wisrovi/Hospital-smart-bracelet/Web/ServidorPulseraNurcall/build/web/resources/image/iBeacon.jpg

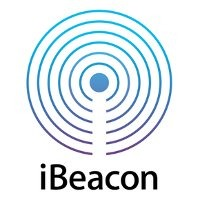
Web/ServidorPulseraNurcall/build/web/resources/image/iBeacon.jpg
