wisrovi/Hospital-smart-bracelet/README.md

# Hospital-smart-bracelet
 Pulsera inteligente hospital
