wisrovi/Hospital-smart-bracelet/Web/ServidorPulseraNurcall/web/resources/image/eddystone.jpg

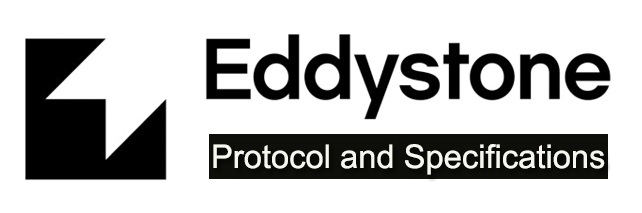
Web/ServidorPulseraNurcall/web/resources/image/eddystone.jpg
