wisrovi/Hospital-smart-bracelet/Componentes Manilla.xls

Sheet: Funcionalidades Manilla
Manilla HSB
Funcionalidad | Componente PCB | Referencia
Deteccion caidas | Acelerometro 3 Ejes | ADXL335 (GY61)
Detectar ubicación | Transmisor beacon | HM10 (CC2540)
Detectar proximidad a valla virtual | Transmisor beacon | HM10 (CC2540)
Detectar si el paciente sigue en su habitación | Transmisor beacon | HM10 (CC2540)
Localizar la persona cuando un sensor supere un umbral establecido | Transmisor beacon | HM10 (CC2540)
Detectar cuando la persona salga de un área (ejemplo: UCI Adultos) | Transmisor beacon | HM10 (CC2540)
Detectar fiebre o hipotermia | Sensor Temperatura | DS18B20
Detectar taquicardia o paro cardiaco | Monitor pulso cardiaco | SEN0203
Detectar cuando la persona se quita la manilla | Sensor Proximidad | QRD1114
Detectar bajo nivel de batería | Sensor nivel batería | ATMEGA328

Sheet: Componentes activos
Cantidad | Componente | Referencia | consumo (mA) | Voltaje Funcionamiento |  | Uso | Taza consulta datos
 |  |  |  | mínimo | máximo |  | actual | máxima
1 | Acelerometro 3 Ejes | ADXL335 (GY61) | -0.35 | 1.8 | 3.6 | Detección choque, movimiento | 20Hz | 550Hz
1 | Monitor pulso cardiaco | SEN0203 | -10 | 3.3 | 6 | Medir pulso cardiaco de la persona | 0,033Hz | 0,033Hz
1 | Sensor Temperatura | DS18B20 | -0.06 |  |  | Medir la temperatura de la persona | 0,016Hz | 0,5Hz
1 | Sensor Proximidad | QRD1114 | -0.3 | 1.8 | 5.6 | Detectar cuando el paciente se quita la pulsera | 0,033Hz | 100Hz
1 | Sensor nivel batería |  | 0 |  |  | Detectar bajo nivel de bateria
1 | Transmisor beacon | HM10 (CC2540) | -9 | 3.3 | 5 | Enviar todos los datos incluyendo la ubicación | 1Hz | 15Hz
1 | Microcontrolador | ATMEGA328 (TQFP-32) | -8 | 1.8 | 5.5 |  | NA | NA
 |  | Consumo carga | -27.71
1 | Bateria litio |  | 850 | 2.7 | 4.1 | Energia para todo el circuito | NA | NA
1 | Carga Inalambrico |  | 80 | NA | NA | Recarga Bateria | NA | NA
1 | Carga Magnetica |  | 2000 | NA | NA | Recarga Bateria | NA | NA
 |  | Horas uso bateria | 31
 | Microcontrolador
 | Pin | Uso | Tipo
 | D0 | Rx | Programador
 | D1 | Tx | Programador
 | D2 | C_bat | Detección sistema cargando
 | D3 | Rx_BLE | UART virtual
 | D4 | Tx_BLE | UART virtual
 | D5 | Vcc DS18B20 | Out digital
 | D6 | Value temperature | Input OneWire
 | D7 | Vcc_ PPM | output digital
 | D8 | Vcc proximidad | output digital
 | D9 | Value proximidad | input digital
 | D10 | vcc acelerometro | output digital
 | D11 | MOSI – programación | digital
 | D12 | MISO – programación | digital
 | D13 | SCK – programación | digital
 | A0 | Value PPM | analog input
 | A1 | Vcc BLE | output digital
 | A2 | acelerometro X | analog input
 | A3 | acelerometro Y | analog input
 | A4 | acelerometro Z | analog input
 | A5 | sensar nivel bateria | analog input
 | A6
 | A7

Sheet: Componentes Pasivos
Componente
Módulo Bluetooth 4.0 HM-10 CC2540/CC2541 BLE Rs232
Micro ATMEGA328P TQFP-32
Resistencia 4.7KΩ 1206 SMD 1/4W
Resistencia 10KΩ 1206 SMD 1/4W
Resistencia 1KΩ 1206 SMD 1/4W
Pulsador pequeño SMD 4 pines - 1mm
Resistencia 330KΩ 1206 SMD 1/4W
Cristal 16 MHz superficial Ref: CRT-16MHZ-SMD
Condensador 22pF 50V encapsulado 0805
Resistencia 2KΩ 1206 SMD 1/4W
Resistencia 680KΩ 1206 SMD 1/4W
Capacitor cerámico 0.1uF 50V encapsulado 0805
Batería Litio-Polímero 3.7V 850mAh
Cargador micro-USB para batería litio - 3.7v
Modulo de carga inalambrica - 5V / 600mA
Conector Macho JST PH 2 Posiciones (recto)
Cable JST PH 2 lineas
Capacitor electrolítico aluminio 680uF 16V SMD
