wisrovi/Hospital-smart-bracelet/Componentes HSB y Baliza/Listado de componentes Baliza y HSB.xlsx

Sheet: Componentes HSB
Componentes HSB
Producto | Imagén | URL Página | Proveedor | Cantidad Actual | Cantidad Requerida | Precio Unidad | Precio Total | Precio Unidad Costo por Manilla
PCB |  |  |  | 5 | 0 | $0.00 | $0.00 | $24000.00
Módulo Bluetooth 4.0 HM-10 CC2540/CC2541 BLE Rs232 | Imagen | Link (https://www.ardobot.co/modulo-bluetooth-4-0-hm-10-cc2540-cc2541-ble-rs232.html) | Ardobot | 2 | 2 | $27500.00 | $55000.00 | $27500.00
Micro ATMEGA328P TQFP-32 | Imagen | Link (https://www.didacticaselectronicas.com/index.php/microcontroladores/atmel/microcontrolador-atmel-atmega328p-mcu-tqfp-32-detail) | Didacticaselectronicas | 3 | 2 | $12257.00 | $24514.00 | $12257.00
Monitor de ritmo cardíaco PPM SEN0203 | Imagen | Link (https://www.didacticaselectronicas.com/index.php/sensores/biomedicos/monitor-ritmo-cardiaco-sensor-sensores-de-medidor-pulso-card%C3%ADaco-ritmo-card%C3%ADaco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) | Didacticaselectronicas | 1 | 3 | $83300.00 | $249900.00 | $83300.00
Sensor Digital de Temperatura DS18B20 | Imagen | Link (https://www.didacticaselectronicas.com/index.php/sensores/temperatura/termometro-digital-de-resolucion-programable-to-92-sensor-sensores-de-temperatura-termom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) | Didacticaselectronicas | 3 | 2 | $4403.00 | $8806.00 | $4403.00
Resistencia 4.7KΩ 1206 SMD 1/4W | Imagen | Link (https://www.didacticaselectronicas.com/index.php/componentes-pasivos/resistencias/montaje-superficial-smd/1206-1/resistencias-1206-smd-4-7k-1-4w-superficial-1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) | Didacticaselectronicas | 0 | 10 | $49.98 | $499.80 | $49.98
Sensor Acelerómetro de 3 Ejes ADXL335 GY61 | Imagen | Link (https://www.didacticaselectronicas.com/index.php/sensores/acelerometros-gyros/modulo-acelerometro-adxl335-tarjetas-sensores-aceler%C3%B3metros-3-ejes-3-grados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) | Vistronica | 3 | 3 | $13299.44 | $39898.32 | $13299.44
Sensor Proximidad QRD1114 | Imagen | https://www.didacticaselectronicas.com/index.php/robotica/seguidores-de-linea-1/sensor-optico-reflectivo-sensor-seguidor-de-linea-seguidores-de-lineas-seguimi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 | Didacticaselectronicas | 1 | 4 | $1785.00 | $7140.00 | $1785.00
Resistencia 10KΩ 1206 SMD 1/4W | Imagen |  |  |  | 0 | $0.00 | $0.00 | $49.98
Resistencia 1KΩ 1206 SMD 1/4W | Imagen |  |  |  | 0 | $0.00 | $0.00 | $49.98
Pulsador pequeño SMD 4 pines - 1mm | Imagen | Link (https://www.didacticaselectronicas.com/index.php/suiches-y-conectores/suiches/pulsadores/pulsador-peque%C3%B1o-smd-4-pines-1mm-interruptor-switch-suiche-pulsa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) | Didacticaselectronicas | 11 | 10 | $330.20 | $3302.00 | $330.20
Resistencia 330KΩ 1206 SMD 1/4W | Imagen | Link (https://www.didacticaselectronicas.com/index.php/componentes-pasivos/resistencias/montaje-superficial-smd/1206-1/resistencias-1206-330-ohm-smd-14w-resistencia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) | Didacticaselectronicas |  | 10 | $49.98 | $499.80 | $49.98
Cristal 16 MHz superficial Ref: CRT-16MHZ-SMD | Imagen | Link (https://www.didacticaselectronicas.com/index.php/componentes-pasivos/cristales-y-osciladores/cristal-16-mhz-superficial2016-02-08-04-34-49_-smd-oscilador-reso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) | Didacticaselectronicas | 4 | 10 | $404.60 | $4046.00 | $404.60
Condensador 22pF 50V encapsulado 0805 | Imagen | Link (https://www.didacticaselectronicas.com/index.php/componentes-pasivos/capacitores/ceramicos/capacitor-ceramico-22pf-50v-encapsulado-0805-caondensadores-capacit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) | Didacticaselectronicas | 10 | 10 | $70.21 | $702.10 | $70.21
Resistencia 2KΩ 1206 SMD 1/4W | Imagen |  |  |  | 0 | $0.00 | $0.00 | $49.98
Resistencia 680KΩ 1206 SMD 1/4W | Imagen |  |  |  | 0 | $0.00 | $0.00 | $49.98
Capacitor cerámico 0.1uF 50V encapsulado 0805 | Imagen | Link (https://www.didacticaselectronicas.com/~didactic/index.php/componentes-pasivos/capacitores/ceramicos/capacitor-ceramico-01uf-50v-encapsulado-0805-condensadore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) | Didacticaselectronicas | 1 | 10 | $40.46 | $404.60 | $40.46
Batería Litio-Polímero 3.7V 850mAh | Imagen | Link (https://www.didacticaselectronicas.com/index.php/baterias-cargadores/recargables-1/tipo-lipo-1/3-7v/bater%C3%ADa-litio-pol%C3%ADmero-3-7v-850mah-ion-pol-35709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) | Didacticaselectronicas | 2 | 2 | $17850.00 | $35700.00 | $17850.00
Cargador micro-USB para batería litio - 3.7v | Imagen | Link (https://www.didacticaselectronicas.com/index.php/baterias-cargadores/cargadores-1/tp4056-3-cargador-micro-usb-para-bater%C3%ADa-litio-3-7v-1s-cargador-control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) | Didacticaselectronicas | 1 | 3 | $3808.00 | $11424.00 | $3808.00
Modulo de carga inalambrica - 5V / 600mA | Imagen | Link (https://www.ardobot.co/modulo-de-carga-inalambrica-5v-600ma.html) | Ardobot | 1 | 1 | $38250.00 | $38250.00 | $38250.00
Conector Macho JST PH 2 Posiciones (recto) | Imagen | Link (https://www.didacticaselectronicas.com/index.php/suiches-y-conectores/conectores2016-02-07-20-36-39_/jst-1/conector-macho-ph-2-posiciones-recto-conector-ph-js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) | Didacticaselectronicas | 1 | 5 | $737.80 | $3689.00 | $737.80
Cable JST PH 2 lineas | Imagen | Link (https://www.didacticaselectronicas.com/index.php/cables/con-conector/jst/cable-doble-con-conector-hembra-jst-ph-2p-a%C3%A9reo-dos-lineas-pololu-cable-doble-js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) | Didacticaselectronicas | 1 | 5 | $1190.00 | $5950.00 | $1190.00
Capacitor electrolítico aluminio 680uF 16V SMD | Imagen | https://www.didacticaselectronicas.com/index.php/componentes-pasivos/capacitores/electrolitico-aluminio/montaje-superficial-smd-1/capacitor-electrol%C3%ADtico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 | Didacticaselectronicas | 1 | 4 | $749.70 | $2998.80 | $749.70
 |  |  |  |  |  | TOTAL | $492724.42 | $230275.29
Proveedor |  | Total | Envío | Total
Vistronica |  | $39898.32 | $11500.00 | $51398.32
Ardobot |  | $93250.00 | $13000.00 | $106250.00
Didacticaselectronicas |  | $359576.10 | $11900.00 | $371476.10
Total |  | $492724.42 |  | $529124.42

Sheet: Componentes Baliza
Componentes Baliza
Producto | URL Página | Proveedor | Cantidad Actual | Cantidad Requerida | Precio Unidad | Precio Total
PCB | - | - | 1 | 0 | $0 | $0
ESP32s | Link (https://www.ardobot.co/board-de-desarrollo-con-modulo-esp32-wifi-bluetooth-ble.html) | Ardobot | 4 | 1 | $30200.00 | $30200.00
HM10 | Link (https://www.ardobot.co/modulo-bluetooth-4-0-hm-10-cc2540-cc2541-ble-rs232.html) | Ardobot | 4 | 1 | $27500.00 | $27500.00
 |  |  |  |  | TOTAL | $57700.00

Sheet: Fotos componentes
Componente | Imagen
Módulo Bluetooth 4.0 HM-10 CC2540/CC2541 BLE Rs232
Micro ATMEGA328P TQFP-32
Monitor de ritmo cardíaco PPM SEN0203
Sensor Digital de Temperatura DS18B20
Resistencia 4.7KΩ 1206 SMD 1/4W
Sensor Acelerómetro de 3 Ejes ADXL335 GY61
Sensor Proximidad QRD1114
Resistencia 10KΩ 1206 SMD 1/4W
Resistencia 1KΩ 1206 SMD 1/4W
Pulsador pequeño SMD 4 pines - 1mm
Resistencia 330KΩ 1206 SMD 1/4W
Cristal 16 MHz superficial Ref: CRT-16MHZ-SMD
Condensador 22pF 50V encapsulado 0805
Resistencia 2KΩ 1206 SMD 1/4W
Resistencia 680KΩ 1206 SMD 1/4W
Capacitor cerámico 0.1uF 50V encapsulado 0805
Batería Litio-Polímero 3.7V 850mAh
Cargador micro-USB para batería litio - 3.7v
Modulo de carga inalambrica - 5V / 600mA
Conector Macho JST PH 2 Posiciones (recto)
Cable JST PH 2 lineas
Capacitor electrolítico aluminio 680uF 16V SMD
