wisrovi/Hospital-smart-bracelet/Componentes HSB y Baliza/Listado de componentes para proveedor.xlsx

Sheet: Componentes HSB
Producto | Imagén | Cantidad Requerida 4 HSB 5 Balizas | Cantidad Requerida 3 HSB 4 Balizas | Cantidad Requerida 2 HSB 4 Balizas | Cantidad Actual
Módulo Bluetooth 4.0 HM-10 CC2540/CC2541 BLE Rs232 | Imagen | 3 | 1 | 1 | 6
Micro ATMEGA328P TQFP-32 | Imagen | 4 | 3 | 2 | 2
Monitor de ritmo cardíaco PPM SEN0203 | Imagen | 3 | 2 | 1 | 1
Sensor Digital de Temperatura DS18B20 | Imagen | 4 | 3 | 2 | 2
Resistencia 4.7KΩ 1206 SMD 1/4W | Imagen | 10 | 10 | 10 | 0
Sensor Acelerómetro de 3 Ejes ADXL335 GY61 | Imagen | 2 | 1 | 1 | 3
Sensor Proximidad QRD1114 | Imagen | 5 | 4 | 3 | 1
Resistencia 10KΩ 1206 SMD 1/4W | Imagen | 10 | 10 | 10 | 0
Resistencia 1KΩ 1206 SMD 1/4W | Imagen | 10 | 10 | 10 | 0
Pulsador pequeño SMD 4 pines - 1mm | Imagen | 10 | 10 | 10 | 0
Resistencia 330 Ω 1206 SMD 1/4W | Imagen | 10 | 10 | 10 | 0
Cristal 16 MHz superficial Ref: CRT-16MHZ-SMD | Imagen | 10 | 10 | 10 | 0
Condensador 22pF 50V encapsulado 0805 | Imagen | 10 | 10 | 10 | 0
Resistencia 2KΩ 1206 SMD 1/4W | Imagen | 10 | 10 | 10 | 0
Resistencia 680 Ω 1206 SMD 1/4W | Imagen | 10 | 10 | 10 | 0
Capacitor cerámico 0.1uF 50V encapsulado 0805 | Imagen | 10 | 10 | 10 | 0
Batería Litio-Polímero 3.7V 850mAh | Imagen | 3 | 2 | 1 | 2
Cargador micro-USB para batería litio - 3.7v | Imagen | 3 | 2 | 1 | 1
Modulo de carga inalambrica - 5V / 600mA | Imagen | 1 | 1 | 1 | 1
Conector Macho JST PH 2 Posiciones (recto) | Imagen | 5 | 5 | 5 | 1
Cable JST PH 2 lineas | Imagen | 5 | 5 | 5 | 1
Capacitor electrolítico aluminio 680uF 16V SMD | Imagen | 10 | 10 | 10 | 0
Módulo ESP32 WiFi+Bluetooth BLE | Imagen | 2 | 1 | 0 | 3
Resistencia 100 Ω 1206 SMD 1/4W | Imagen | 10 | 10 | 10 | 0

Sheet: Vistronica
ITEM | NOMBRE DEL PRODUCTO | Referencia | UNIDAD DE MEDIDA | CANTIDAD | VALOR UNITARIO | VALOR TOTAL SIN IVA | VALOR IVA | VALOR TOTAL CON IVA
1 | MÓDULO BLUETOOTH 4.0BLE AT- 09 CC2541 HM-10 | VIS2412 | Unidad | 3 | $14500 | $43500.00 | $8265.00 | $51765.00
2 | MICROCONTROLADOR ATMEGA328P SMD TQFP-32 | VIS2842 | Unidad | 2 | $8248 | $16495.80 | $3134.20 | $19630.00
3 | Gravity: Heart Rate Monitor Sensor for Arduino SEN0203 |  | Unidad | 3 | $78125 | $234375.13 | $44531.27 | $278906.40
4 | SENSOR DIGITAL DE TEMPERATURA DS18B20 | VIS304 | Unidad | 2 | $3697 | $7394.96 | $1405.04 | $8800.00
5 | RESISTENCIAS 4.7 KOHM SMD 1206 1/4W 5% X10 | VIS2935 | Unidad | 10 | $286 | $2857.14 | $542.86 | $3400.00
6 | ACELERÓMETRO DE 3 EJES ADXL335 GY61 | VIS1435 | Unidad | 3 | $11176 | $33526.89 | $6370.11 | $39897.00
7 | SENSOR ÓPTICO REFLEXIVO QRD1114 | VIS1262 | Unidad | 4 | $2400 | $9600.00 | $1824.00 | $11424.00
8 | Resistencia 10KΩ 1206 SMD 1/4W |  | Unidad | 10 | $78 | $780.00 | $148.20 | $928.20
9 | Resistencia 1KΩ 1206 SMD 1/4W |  | Unidad | 20 | $78 | $1560.00 | $296.40 | $1856.40
10 | MICRO PULSADOR DE 4 PINES 6*6*7 SMD | VIS2344 | Unidad | 10 | $80 | $800.00 | $152.00 | $952.00
11 | Resistencia 330KΩ 1206 SMD 1/4W |  | Unidad | 10 | $80 | $800.00 | $152.00 | $952.00
12 | CRISTAL OSCILADOR DE 16 MHZ SMD HC-49S | VIS2838 | Unidad | 10 | $306 | $3060.00 | $581.40 | $3641.40
13 | CAPACITOR CERÁMICO 22 PF 50V YAGEO SMD 0805 X10 | VIS3030 | Unidad | 10 | $403 | $4033.61 | $766.39 | $4800.00
14 | Resistencia 2KΩ 1206 SMD 1/4W |  | Unidad | 10 | $80 | $800.00 | $152.00 | $952.00
15 | Resistencia 680KΩ 1206 SMD 1/4W |  | Unidad | 10 | $80 | $800.00 | $152.00 | $952.00
16 | Capacitor cerámico 0.1uF 50V encapsulado 0805 |  | Unidad | 10 | $247 | $2470.00 | $469.30 | $2939.30
17 | BATERÍA DE LIPO 3.7V 1240 MAH | VIS1839 | Unidad | 2 | $18992 | $37983.19 | $7216.81 | $45200.00
18 | MODULO CARGADOR DE BATERÍAS LIPO MICRO USB 5V 1A TP4056 paa baterias de 3,7v | VIS2680 | Unidad | 3 | $2200 | $6600.00 | $1254.00 | $7854.00
19 | MODULO FUENTE DE ALIMENTACIÓN INALÁMBRICA XKT-412 5V 1 A | VIS1692 | Unidad | 1 | $48700 | $48700.00 | $9253.00 | $57953.00
20 | Conector Macho JST PH 2 Posiciones (recto) |  | Unidad | 5 | $959 | $4795.71 | $911.19 | $5706.90
21 | Cable JST PH 2 lineas |  | Unidad | 5 | $1547 | $7735.00 | $1469.65 | $9204.65
22 | Capacitor electrolítico aluminio 680uF 16V SMD |  | Unidad | 4 | $975 | $3898.45 | $740.71 | $4639.16
23 | BOARD NODEMCU WIFI BASADO EN ESP32 | VIS2674 | Unidad | 1 | $27720 | $27720.00 | $5266.80 | $32986.80
 |  |  |  |  |  | SUBTOTAL | $500286
 |  |  |  |  |  | IVA | $95054
 |  |  |  |  |  | ENVÍO | $12000
 |  |  |  |  |  | VALOR TOTAL | $607340

Sheet: Ardobot
Producto | Precio Unidad | Cantidad Requerida 4 HSB 5 Balizas | Precio Total | Cantidad Requerida 3 HSB 4 Balizas | Precio Total | Cantidad Requerida 2 HSB 3 Balizas | Precio Total | Cantidad Requerida 2 HSB 3 Balizas | Precio Total
Módulo Bluetooth 4.0 HM-10 CC2540/CC2541 BLE Rs232 | $27500 | 3 | $82500 | 1 | $27500 | 0 | $0 | 0 | $0
Micro ATMEGA328P TQFP-32 | $15200 | 4 | $60800 | 3 | $45600 | 2 | $30400 | 2 | $30400
Monitor de ritmo cardíaco PPM SEN0203 | $87000 | 3 | $261000 | 2 | $174000 | 1 | $87000 | 2 | $174000
Sensor Digital de Temperatura DS18B20 | $6999 | 4 | $27996 | 3 | $20997 | 2 | $13998 | 1 | $6999
Resistencia 4.7KΩ 1206 SMD 1/4W | $50 | 10 | $500 | 10 | $500 | 10 | $500 | 10 | $500
Sensor Acelerómetro de 3 Ejes ADXL335 GY61 | $14900 | 2 | $29800 | 1 | $14900 | 1 | $14900 | 0 | $0
Sensor Proximidad QRD1114 | $3500 | 4 | $14000 | 4 | $14000 | 3 | $10500 | 2 | $7000
Resistencia 10KΩ 1206 SMD 1/4W | $60 | 10 | $600 | 10 | $600 | 10 | $600 | 10 | $600
Resistencia 1KΩ 1206 SMD 1/4W | $50 | 10 | $500 | 10 | $500 | 10 | $500 | 10 | $500
Pulsador pequeño SMD 4 pines - 1mm | $550 | 10 | $5500 | 10 | $5500 | 10 | $5500 | 10 | $5500
Resistencia 330 Ω 1206 SMD 1/4W | $50 | 10 | $500 | 10 | $500 | 10 | $500 | 10 | $500
Cristal 16 MHz superficial Ref: CRT-16MHZ-SMD | $500 | 10 | $5000 | 10 | $5000 | 10 | $5000 | 10 | $5000
Condensador 22pF 50V encapsulado 0805 | $250 | 10 | $2500 | 10 | $2500 | 10 | $2500 | 10 | $2500
Resistencia 2KΩ 1206 SMD 1/4W | $50 | 10 | $500 | 10 | $500 | 10 | $500 | 10 | $500
Resistencia 680 Ω 1206 SMD 1/4W | $50 | 10 | $500 | 10 | $500 | 10 | $500 | 10 | $500
Capacitor cerámico 0.1uF 50V encapsulado 0805 | $580 | 10 | $5800 | 10 | $5800 | 10 | $5800 | 10 | $5800
Batería Litio-Polímero 3.7V 850mAh | $28500 | 3 | $85500 | 2 | $57000 | 1 | $28500 | 1 | $28500
Cargador micro-USB para batería litio - 3.7v | $15000 | 3 | $45000 | 2 | $30000 | 1 | $15000 | 1 | $15000
Modulo de carga inalambrica - 5V / 600mA | $38250 | 1 | $38250 | 1 | $38250 | 1 | $38250 | 1 | $38250
Conector Macho JST PH 2 Posiciones (recto) | $1550 | 5 | $7750 | 5 | $7750 | 5 | $7750 | 5 | $7750
Cable JST PH 2 lineas | $1800 | 5 | $9000 | 5 | $9000 | 5 | $9000 | 5 | $9000
Capacitor electrolítico aluminio 680uF 16V SMD | $850 | 10 | $8500 | 10 | $8500 | 10 | $8500 | 10 | $8500
Módulo ESP32 WiFi+Bluetooth BLE | $35680 | 2 | $71360 | 1 | $35680 | 0 | $0 | 0 | $0
Resistencia 100 Ω 1206 SMD 1/4W | $50 | 10 | $500 | 10 | $500 | 10 | $500 | 10 | $500
 |  | TOTAL | $763856 | TOTAL | $505577 | TOTAL | $286198 | TOTAL | $347799
Corregir las resistencias son de 680Ω y 330Ω

Sheet: Fotos componentes
Componente | Imagen
Módulo Bluetooth 4.0 HM-10 CC2540/CC2541 BLE Rs232
Micro ATMEGA328P TQFP-32
Monitor de ritmo cardíaco PPM SEN0203
Sensor Digital de Temperatura DS18B20
Resistencia 4.7KΩ 1206 SMD 1/4W
Sensor Acelerómetro de 3 Ejes ADXL335 GY61
Sensor Proximidad QRD1114
Resistencia 10KΩ 1206 SMD 1/4W
Resistencia 1KΩ 1206 SMD 1/4W
Pulsador pequeño SMD 4 pines - 1mm
Resistencia 330KΩ 1206 SMD 1/4W
Cristal 16 MHz superficial Ref: CRT-16MHZ-SMD
Condensador 22pF 50V encapsulado 0805
Resistencia 2KΩ 1206 SMD 1/4W
Resistencia 680KΩ 1206 SMD 1/4W
Capacitor cerámico 0.1uF 50V encapsulado 0805
Batería Litio-Polímero 3.7V 850mAh
Cargador micro-USB para batería litio - 3.7v
Modulo de carga inalambrica - 5V / 600mA
Conector Macho JST PH 2 Posiciones (recto)
Cable JST PH 2 lineas
Capacitor electrolítico aluminio 680uF 16V SMD
Módulo ESP32 WiFi+Bluetooth BLE
Resistencia 100 Ω 1206 SMD 1/4W
