wisrovi/Hospital-smart-bracelet/Pulsera/Componentes HSB.xlsx

Sheet: Productos
Producto | Precio | Unidades | Total | URL
Acelerómetro de 3 Ejes ADXL335 GY61 | $13299 | 2 | $26598 | https://www.vistronica.com/sensores/imu/acelerometro-de-3-ejes-adxl335-gy61-detail.html
Sensor Digital de Temperatura DS18B20 | $4400 | 3 | $13200 | https://www.vistronica.com/sensores/temperatura/sensor-digital-de-temperatura-ds18b20-detail.html
Resistencias 100 KOHM SMD 1206 1/4W 5% x10 | $340 | 1 | $340 | https://www.vistronica.com/componentes-pasivos/resistencias/resistencias-100-kohm-smd-1206-14w-5-x10-detail.html
Resistencias 1 MOHM SMD 1206 1/4W 5% x10 | $340 | 1 | $340 | https://www.vistronica.com/componentes-pasivos/resistencias/resistencias-1-mohm-smd-1206-14w-5-x10-detail.html
Resistencias 22 KOHM SMD 1206 1/4W 5% x10 | $340 | 1 | $340 | https://www.vistronica.com/componentes-pasivos/resistencias/resistencias-22-kohm-smd-1206-14w-5-x10-detail.html
Resistencias 47 KOHM SMD 1206 1/4W 5% x10 | $340 | 1 | $340 | https://www.vistronica.com/componentes-pasivos/resistencias/resistencias-47-kohm-smd-1206-14w-5-x10-detail.html
Resistencias 470 KOHM SMD 1206 1/4W 5% x10 | $340 | 1 | $340 | https://www.vistronica.com/componentes-pasivos/resistencias/resistencias-470-kohm-smd-1206-14w-5-x10-detail.html
Total |  |  | $41498
Envío |  |  | $11000
Total con Envío |  |  | $52498

Sheet: Calculos Vout
Resistencias
Resistencias 1 MOHM SMD 1206 1/4W 5% x10
Resistencias 680 KOHM SMD 1206 1/4W 5% x10
Resistencias 470 KOHM SMD 1206 1/4W 5% x10
Resistencias 100 KOHM SMD 1206 1/4W 5% x10
Resistencias 47 KOHM SMD 1206 1/4W 5% x10
Resistencias 22 KOHM SMD 1206 1/4W 5% x10
Resistencias 680 OHM SMD 1206 1/4W 5% x10
Resistencias 100 OHM SMD 1206 1/4W 5% x10
Resistencias 82 OHM SMD 1206 1/4W 5% x10
Resistencias 68 OHM SMD 1206 1/4W 5% x10
 | R1 | R2 | Vout
 | 100KOhm | 47KOhm | 1.342857143
 | 1MOhm | 470KOhm | 1.342857143
 | 47KOhm | 22KOhm | 1.339130435
 | 1MOhm | 105
 | 470KOhm | 474
 | 22KOhm | 223
 | 47KOhm | 473
 | 100KOhm
 | 100Ohm | 101
