wisrovi/Hospital-smart-bracelet/Pulsera/PCB/Proveedor/FORMATO INFORMACION COMPONENTES PARA COTIZAR (BOM) (Enero 30 2019).xlsx

Sheet: PORTADA
 | ADVERTENCIA: DOCUMENTO ALTAMENTE
 | CONFIDENCIAL PROTEGIDO BAJO SECRETO
 | INDUSTRIAL ART.262 DECISIÓN 486 DE 2000
ESTE DOCUMENTO CONTIENE SECRETOS INDUSTRIALES DE COLCIRCUITOS S.A.S Y SOLO PUEDE SER CONSULTADO O REVELADO POR PERSONAS AUTORIZADAS POR EL TITULAR. LA VISUALIZACIÓN O LA DIVULGACIÓN NO AUTORIZADAS ESTÁN ESTRICTAMENTE PROHIBIDAS Y PUEDEN GENERAR GRAVES SANCIONES LEGALES
 | TITULAR DEL DOCUMENTO LILIANA VELEZ PEREZ (Representante ante el SGC) C.C. 43.749.879
Cotizar pero NO ensamblar
No ensamblar y no cotizar
Cliente lo suministra
Capa Top
Capa Botton
Ambas Capas

Sheet: Listado de COMPONENTES (BOM)
 |  | FORMATO CON LA INFORMACIÓN DE COMPONENTES (BOM) |  |  |  | Código: COM - F
 |  |  |  |  |  | Versión: 04
 |  |  |  |  |  | Fecha: 29 - 01 - 2019
INDICACIONES DE USO DEL FORMATO: Para realizar una correcta manufactura electrónica, es necesario el diligenciamiento de este formato con la información de los componentes de los que está compuesto su proyecto. Agradecemos entregarnos la información específica, sobre todo de la referencia del fabricante del componente y apoyarse en los comentarios de los títulos de la tabla para una mayor información.
ITEM | N° DE PARTE - Según máscara de componentes en la PCB | CANTIDAD DEL COMPONENTE EN LA PCB | DESCRIPCIÓN DEL COMPONENTE | REFERENCIA DE FABRICANTE | UBICACIÓN DEL COMPONENTE - Top o Botton | OBSERVACIONES - indicar si aplica, una de las opciones

Sheet: ORDEN DE ITEM EN EL BOM
SUGERENCIA DE ORDEN DE ITEM PARA EL LISTADO DE COMPONENTES
Resistencias
Condensadores
Diodos
Leds
Bobinas
Fusibles
Cristales
Buzzer
Transistores
Mosfet
Triacs, Diacs, Varistores
Reguladores
Optocopladores
Micros
Modulos GPS GPRS
Displays
Cables
Bases integrados
Baterias
Relevos
Switches
Conectores
Borneras
Conectores ribbon
Cajas
Tornillos
Antenas
