wisrovi/Hospital-smart-bracelet/Pulsera/PCB/Hospital-Smart-Bracelet V1.1/Project Outputs for Hospital-Smart-Bracelet/ExportSTEP/HSB-Version1.step

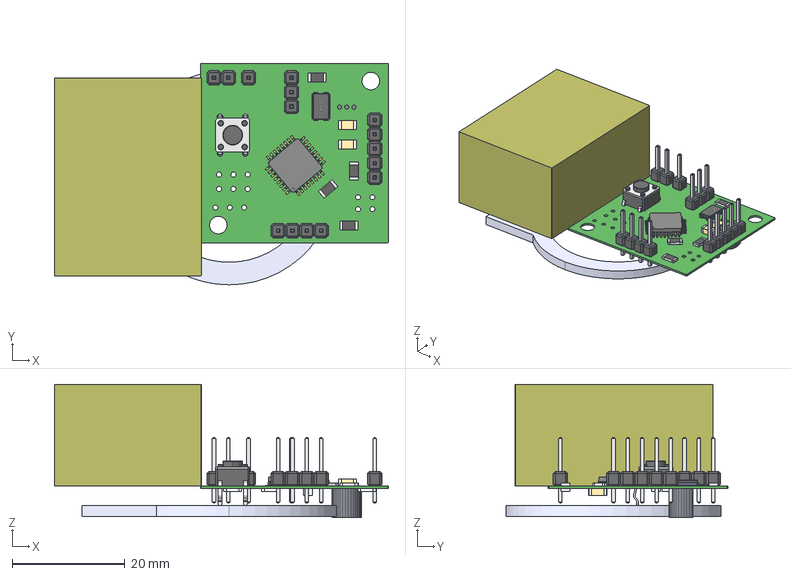
[picture p23: CAD file, 2020-05-28]
Pulsera/PCB/Hospital-Smart-Bracelet V1.1/Project Outputs for Hospital-Smart-Bracelet/ExportSTEP/HSB-Version1.step
59.1 x 39.2 x 23.6 mm
Board
1x1x2.54_Pin_Header_TH_V x 15
C1206-1.25 x 6
R1206-0.55 x 14
2-SMD
Tack_Switch_6x6_1mm
User_Library-QFP32_User_Library-PQFP_32_P0.8_QFPbody_1
User_Library-QFP32_User_Library-PQFP_32_P0.8_QFPleg_1 x 16
User_Library-QFP32_User_Library-PQFP_32_P0.8_QFPleg_MIR1_1 x 8
User_Library-QFP32_User_Library-PQFP_32_P0.8_QFPleg_MIR_1 x 8
Extruded x 2
Base_anillo1
