wisrovi/Hospital-smart-bracelet/Pulsera/PCB/Hospital-Smart-Bracelet V1.1/Project Outputs for Hospital-Smart-Bracelet/gerberEnviar/HSB-Version1.step

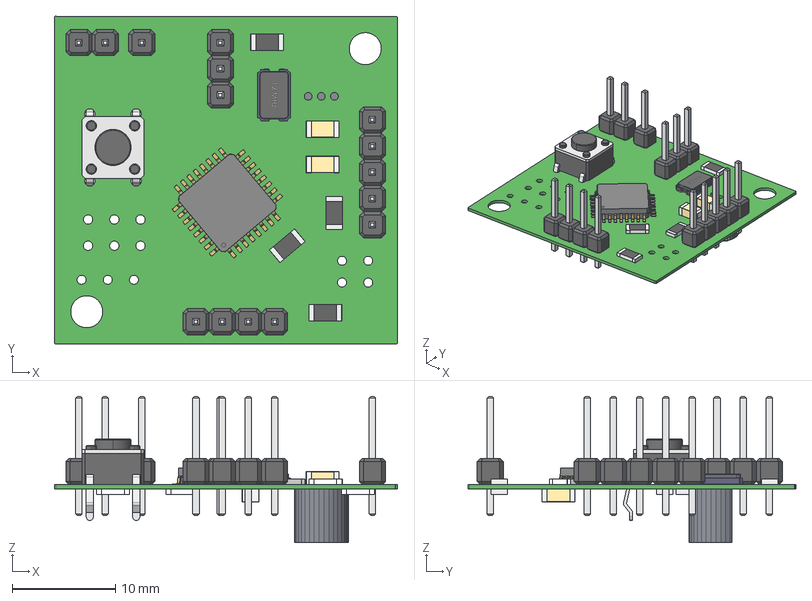
[picture p24: CAD file, 2020-06-18]
Pulsera/PCB/Hospital-Smart-Bracelet V1.1/Project Outputs for Hospital-Smart-Bracelet/gerberEnviar/HSB-Version1.step
33.3 x 31.8 x 14.2 mm
Board
Extruded
R1206-0.55 x 14
1x1x2.54_Pin_Header_TH_V x 15
User_Library-QFP32_User_Library-PQFP_32_P0.8_QFPbody_1
User_Library-QFP32_User_Library-PQFP_32_P0.8_QFPleg_1 x 16
User_Library-QFP32_User_Library-PQFP_32_P0.8_QFPleg_MIR1_1 x 8
User_Library-QFP32_User_Library-PQFP_32_P0.8_QFPleg_MIR_1 x 8
C1206-1.25 x 6
Tack_Switch_6x6_1mm
2-SMD
