wisrovi/Hospital-smart-bracelet/(list of files, cad)

Other CAD files:
Pulsera/PCB/Hospital-Smart-Bracelet V1.1/Project Outputs for Hospital-Smart-Bracelet/PADSNetlist/Hospital-Smart-Bracelet.PRT
