wisrovi/Hospital-smart-bracelet/Pulsera/PCB/Hospital-Smart-Bracelet V1.1/Project Outputs for Hospital-Smart-Bracelet/PDF_3D.PDF

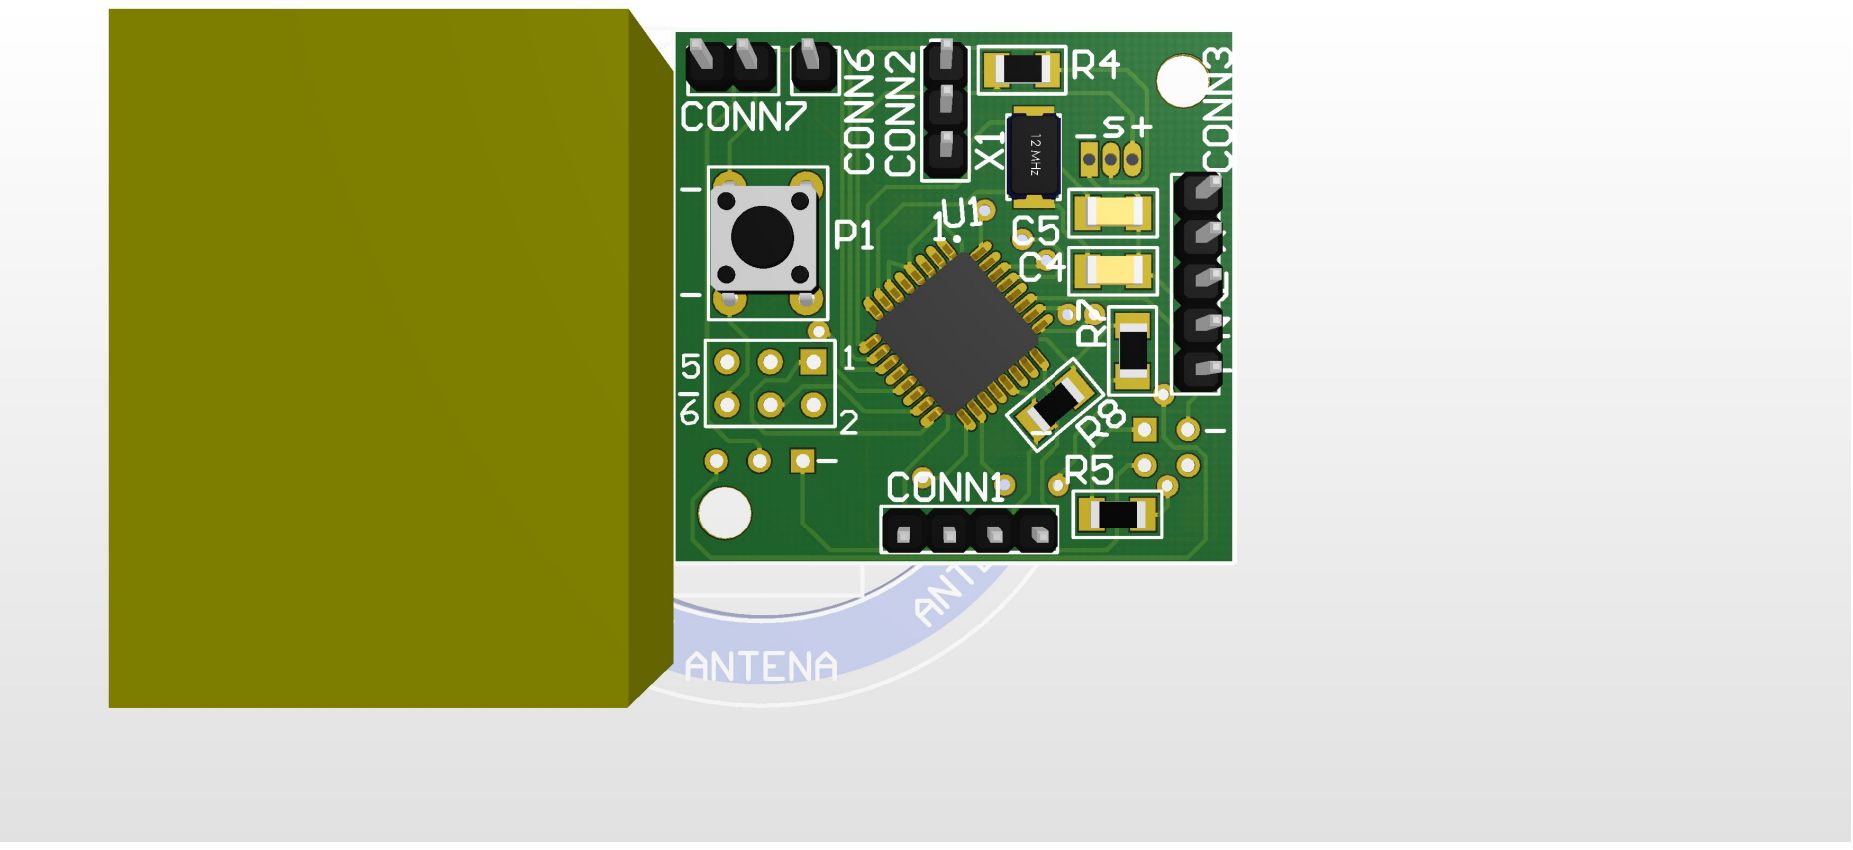
[picture p35: page 1]

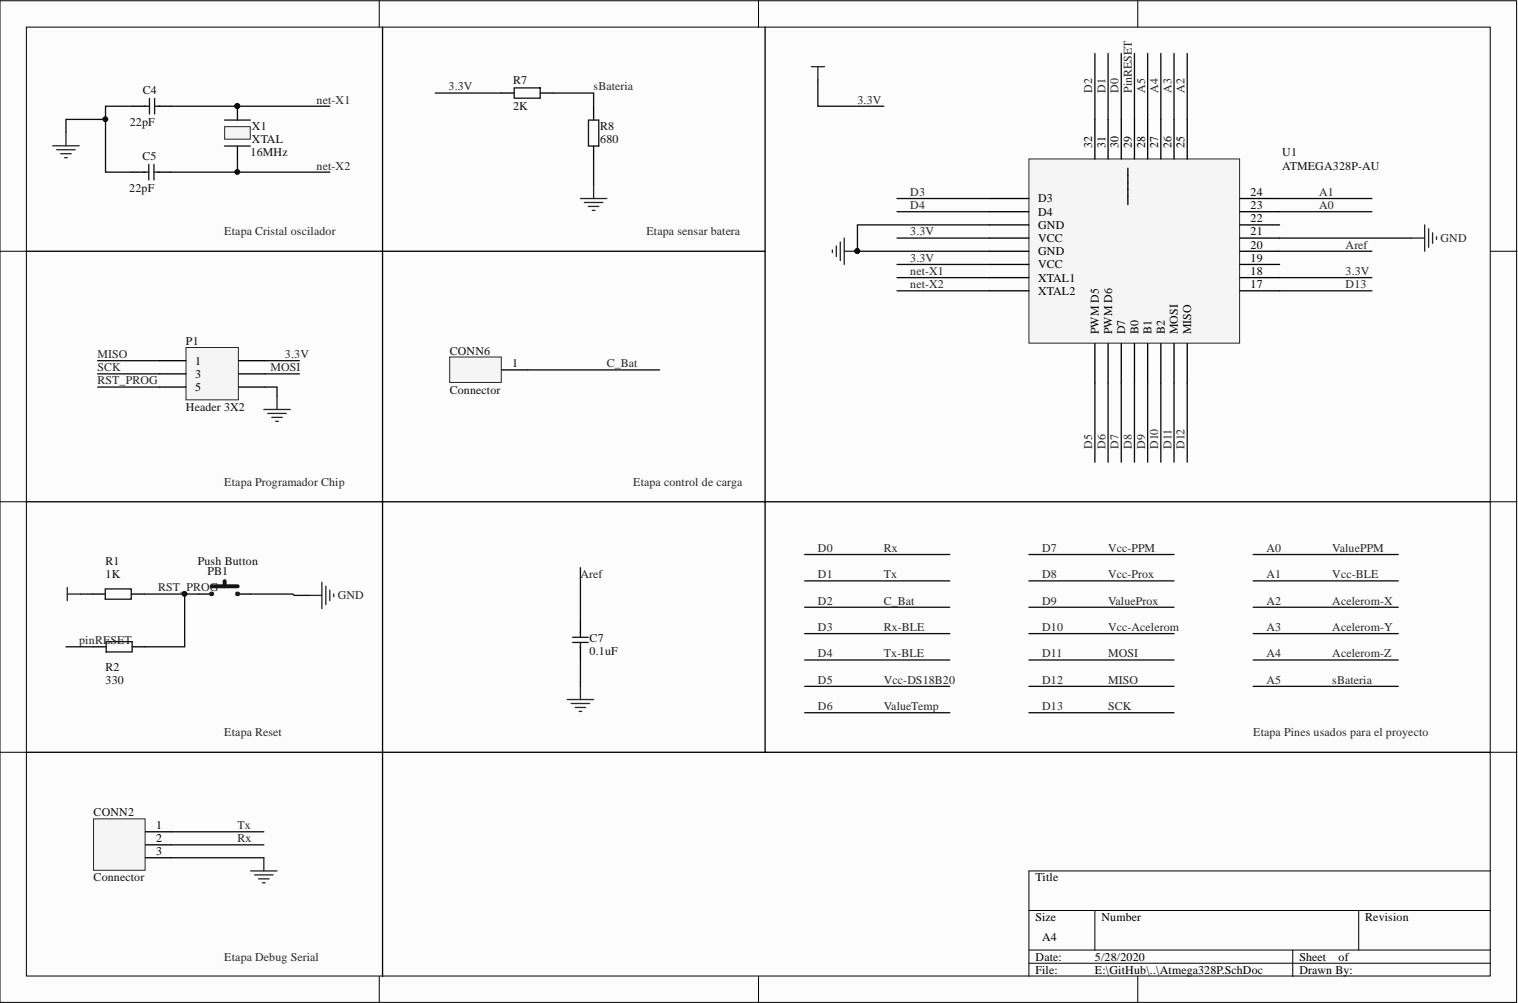
[picture p36: page 3]

Etapa control de carga

Etapa Pines usados para el proyecto

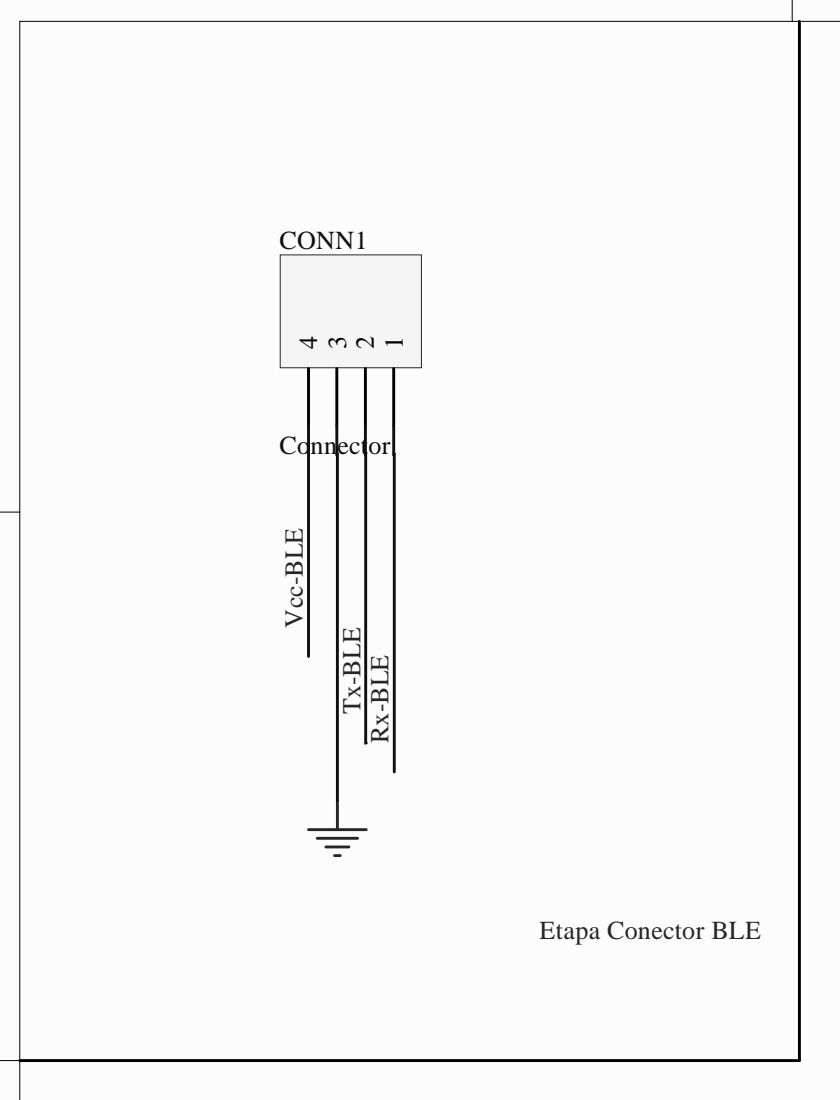
[picture p37: page 4]

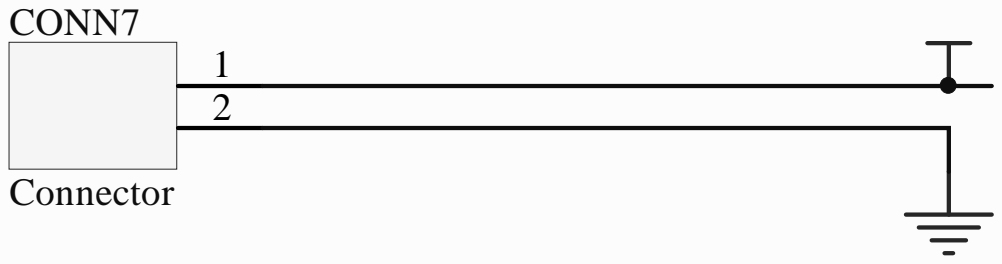
[picture p38: page 5]

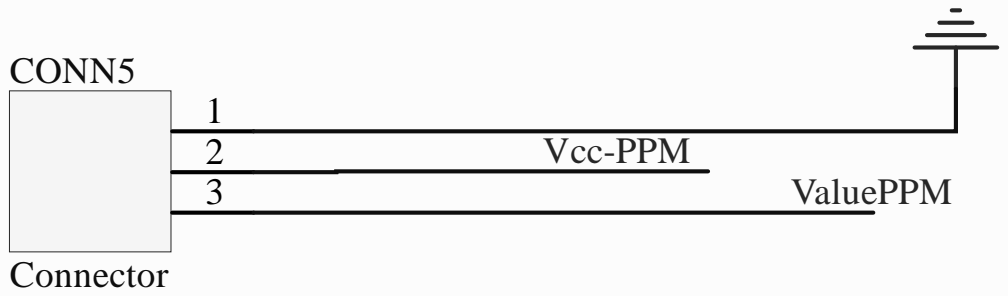
[picture p39: page 6]

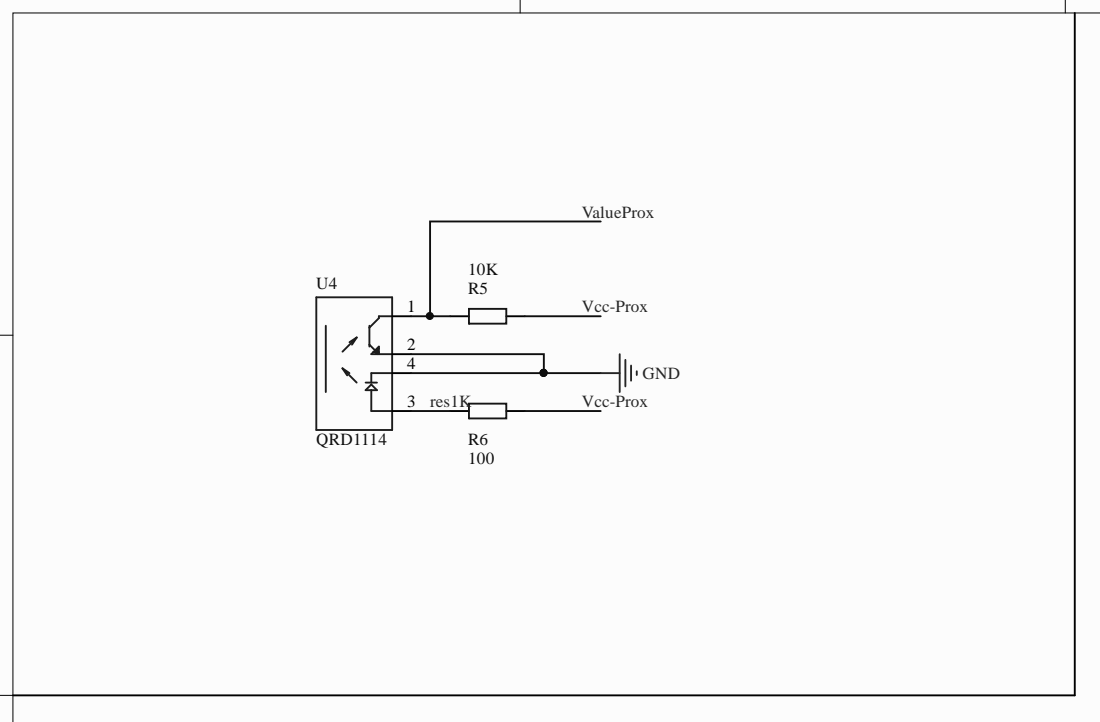
[picture p40: page 7]

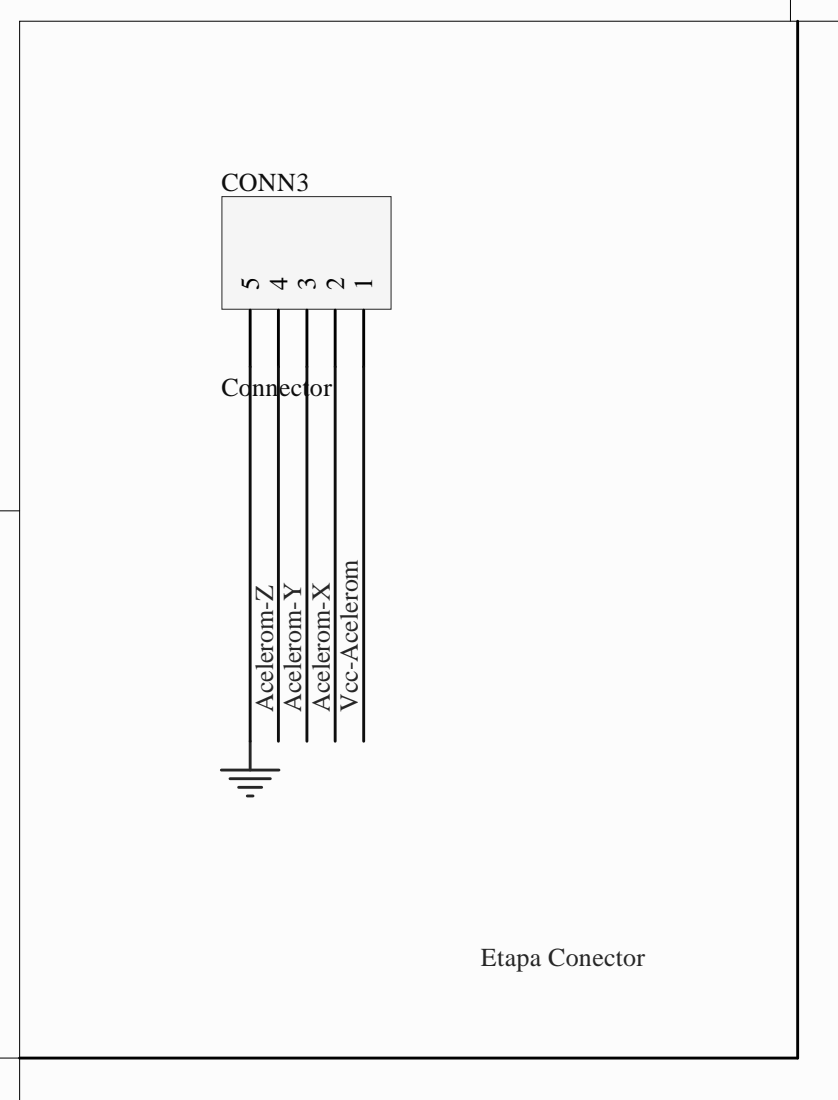
[picture p41: page 8]

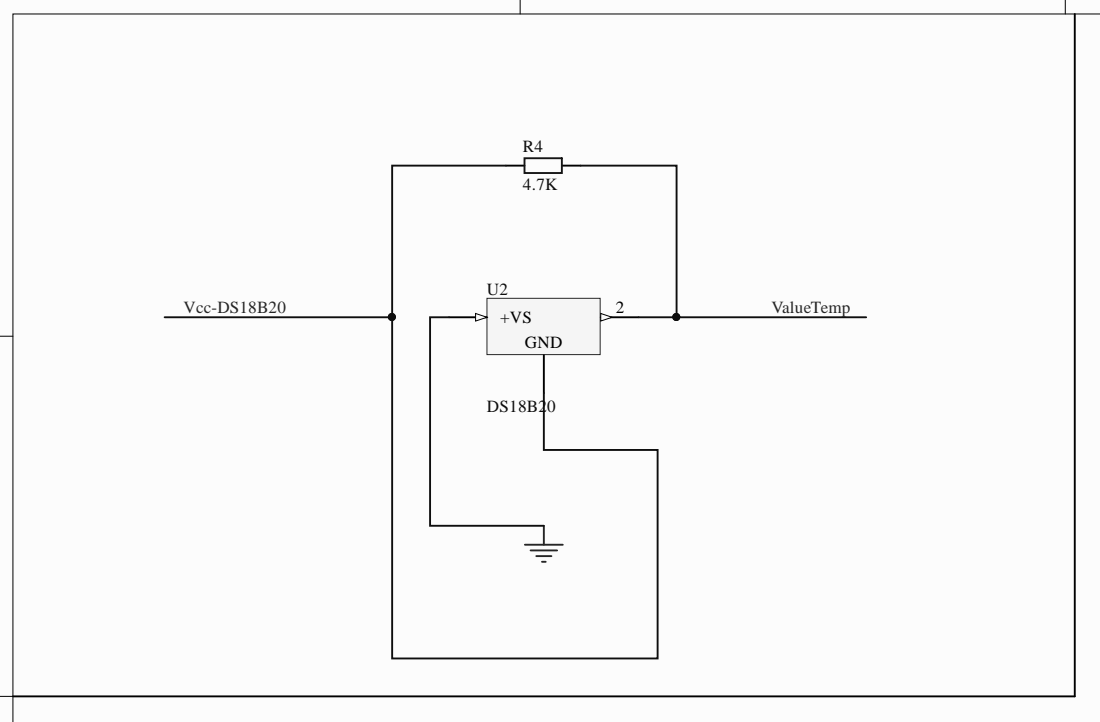
[picture p42: page 9]

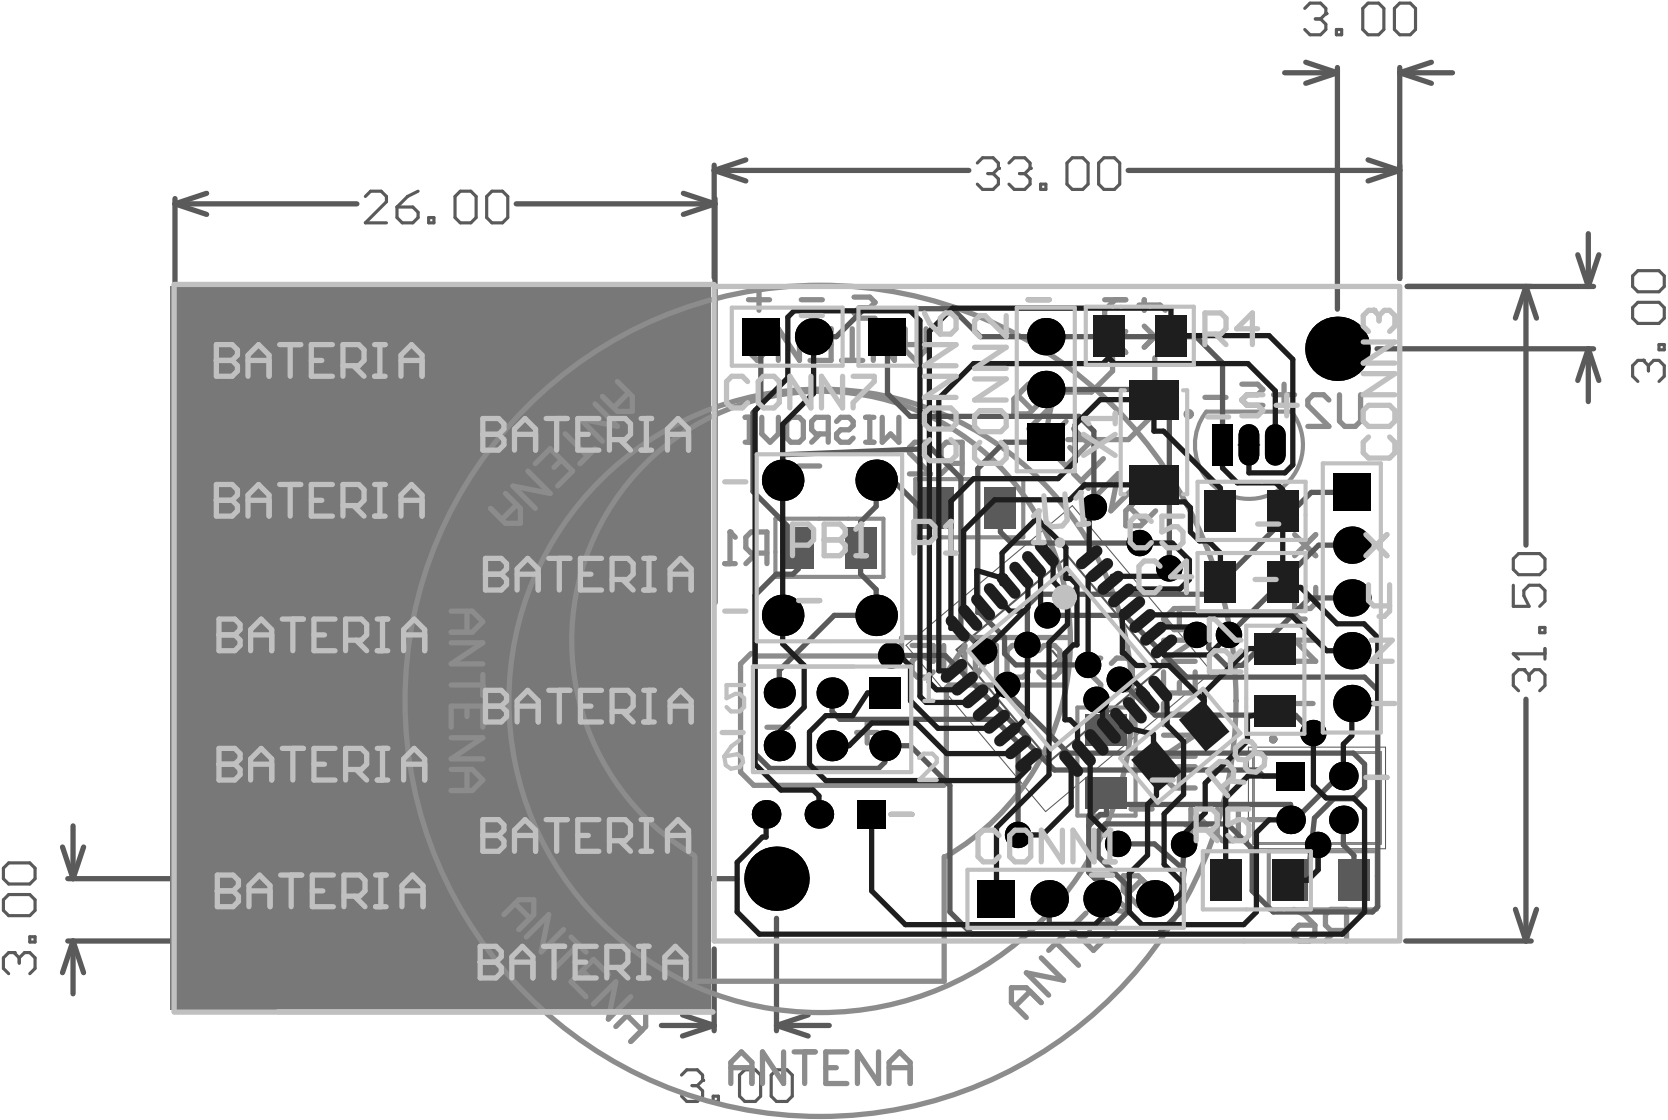
[picture p43: page 10]
