wisrovi/Hospital-smart-bracelet/(list of files, drawings)

Other design files:
Pulsera/PCB/Hospital-Smart-Bracelet V1.1/Atmega328P.SchDoc
Pulsera/PCB/Hospital-Smart-Bracelet V1.1/BLE-HM10.SchDoc
Pulsera/PCB/Hospital-Smart-Bracelet V1.1/CargaInalambrica.SchDoc
Pulsera/PCB/Hospital-Smart-Bracelet V1.1/Hospital-Smart-Bracelet.PrjPcb
Pulsera/PCB/Hospital-Smart-Bracelet V1.1/HSB-Version1.PcbDoc
Pulsera/PCB/Hospital-Smart-Bracelet V1.1/PPM.SchDoc
Pulsera/PCB/Hospital-Smart-Bracelet V1.1/Proximidad.SchDoc
Pulsera/PCB/Hospital-Smart-Bracelet V1.1/SensorCaida.SchDoc
Pulsera/PCB/Hospital-Smart-Bracelet V1.1/Temperatura.SchDoc
