wisrovi/Hospital-smart-bracelet/Baliza/Arduino/libraries290520/BalizaHSBFCV/examples/Baliza_HSB_FCV/Baliza_HSB_FCV.ino

#include "BalizaHSBFCV.h"

BalizaHSBFCV balizahsbfcv;

String Beaconsescaneados = "";

void setup() {
  Serial.begin(9600);
  balizahsbfcv.start_at();
  Serial.println( " setup terminado " );
}

void loop() {
  balizahsbfcv.loopScanear();
  Beaconsescaneados = balizahsbfcv.Totalbeacons();
  if (Beaconsescaneados.length() > 20) {
    Serial.println(Beaconsescaneados);
  }
  delay(1000);
}
