wisrovi/Hospital-smart-bracelet/(commit log)

2020-03-24 Incluiir archivo
    Se incluyo el archivo readme
2020-03-24 nuevas lineas de codigo
    nuevos comandos en readme
2020-03-24 Revert "nuevas lineas de codigo"
    This reverts commit 14fd4046eddedc7e758a6085b772711679e8780c.
2020-03-24 Historial trabajo
    Historial trabajo
    [evidenciasTrabajo.ods]
2020-03-24 update
    se incluye la plantilla de seguimiento del proyecto.
2020-03-24 Inclusión archivos
    PCB y Servidor.
    [Atmega328P.SchDoc, BLE-HM10.SchDoc, CargaInalambrica.SchDoc, HSB-Version1.PcbDoc, Hospital-Smart-Bracelet.PrjPcb, PPM.SchDoc, Proximidad.SchDoc, SensorCaida.SchDoc]
2020-03-24 Se agregan librerias de HSB
    Se agregan sensores pulso cardiaco, Caida, Proximidad, Temperatura y master sensors. Adicional se agrega la programación de HSB para el Control del consumo de batería.
    [evidenciasTrabajo.ods]
2020-03-24 PCB update (48%)
    Se trabaja en la PCB llegando el diseño a un 48%, adicionalmente se incluye una plantilla para los informes rápidos.
    [HSB-Version1.PcbDoc]
2020-03-25 Extracción documento zip
    Se extra el documento del archivo .zip
2020-03-25 Subida documento control version y cambios de PCB
    Subida documento control version y cambios de PCB
    [HSB-Version1.PcbDoc]
2020-03-25 Cambio del cuadro de informe de software
    Se realizó el cambio del cuadro en el docuemnto R-DIT-INST-001
2020-03-25 PCB HSB 98%
    PCB HSB 98%
    [HSB-Version1.PcbDoc, Hospital-Smart-Bracelet.PrjPcb, SensorCaida.SchDoc]
2020-03-26 librerias BalizaFCV
    las librerias utilizadas para enviar inf de los beacons detectados
2020-03-26 Actualización informe pruebas HSB
    Se realiza ctualización informe pruebas HSB y programación de la manilla con control de batería.
2020-03-26 Inclusión PDF PCB
    Inclusión PDF PCB
    [HSB-Version1.PcbDoc, Hospital-Smart-Bracelet.PrjPcb]
2020-03-27 PCB version 1 y Gerber
    PCB version 1 y Gerber
    [Atmega328P.SchDoc, BLE-HM10.SchDoc, Bill of Materials-Hospital-Smart-Bracelet.xls, CargaInalambrica.SchDoc, Component Cross Reference Report-Hospital-Smart-Bracelet.xls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]
2020-03-27 Generador Gerber
    Generador Gerber
2020-03-27 Actualización librerias HSB y informe
    Se actualizo la libreria de mastersensors, y las librerias de los sensores. Adicional se agrego información en el informe de las pruebas realizadas en el día sobre la carga y descarga de la batería.
2020-03-30 Cotización Pulsera
    Cotización Pulsera
    [FORMATO INFORMACION COMPONENTES PARA COTIZAR (BOM) (Enero 30 2019).xlsx]
2020-04-01 PDF 3D
    PDF 3D
    [Hospital-Smart-Bracelet.PrjPcb]
2020-04-01 PDF
    PDF
    [HSB-Version1.PcbDoc, Hospital-Smart-Bracelet.PrjPcb]
2020-04-02 Informe de las librerias usadas para la HSB
    Se agregan los informes de las librerias de Pulso Cardiaco, Proximidad, Temperatura y Caída las cuales se usan en el código de Control de Batería de la HSB.
2020-04-13 Actualizacion Informes
    Se actualizan los informes de Pruebas HSB y libreria mastersensors
2020-04-14 Publicación del informe PCB HSB
    Se agregó el informe de Pruebas de la PCB del HSB
    [evidenciasTrabajo.ods]
2020-04-24 Actualización de los informes y pruebas del HSB
    Se realiza la actualización de los informes de las librerias de temperatura, mastersensor y de los informes de montaje y funcionamiento del HSB.
2020-05-06 Actualización del informe de PCB-HSB
    Se realizó la actualización de las pruebas realizadas a la PCB-HSB
    [Componentes HSB.xlsx]
2020-05-13 Actualizanción de Informes y Libreria de ControlBateriaHSB
    Se realizó la creación del informe de la primera versión de la librería de ControlBateríaHSB.
    Se actualizo los informes de Protoboard y PBC del HSB.
    Se agrego la libreria de ControlBateríaHSB
2020-05-19 cambios
    baliza
    [evidenciasTrabajo.ods]
2020-05-26 Version 2 PCB
    Version 2 PCB
    [Atmega328P.SchDoc, BLE-HM10.SchDoc, Bill of Materials-Hospital-Smart-Bracelet.xls, CargaInalambrica.SchDoc, Component Cross Reference Report-Hospital-Smart-Bracelet.xls, DBpulseraNurcall.ods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]
2020-05-27 PCB V1.1
    PCB V1.1
    [Bill of Materials-Hospital-Smart-Bracelet.xls, Component Cross Reference Report-Hospital-Smart-Bracelet.xls, HSB-Version1.PcbDoc, Hospital-Smart-Bracelet.CSV, Hospital-Smart-Bracelet.PRT, Hospital-Smart-Bracelet.PrjPcb]
2020-05-28 actualización informe PCB HSB
2020-05-28 PDF 3D
    [Hospital-Smart-Bracelet.PrjPcb]
2020-05-30 Server Django
    Server Django
    [ajustar urls en config.txt, ajustar views en config.txt]
2020-06-05 Server recibe y guarda los datos de los sensores
    el servidor ya guarda los datos de los sensores y envia correos cuando los datos no son correctos o si la pulsera no esta registrada, filtra que no hayan datos repetidos y si todo cumple, ya guarda los datos de los sensores en la base de datos.
2020-06-08 informe de sensores
2020-06-12 Informes de baliza y librerias creadas para baliza
    Contiene todos los informes y librerias creadas para baliza.
2020-06-19 Documento con los componentes a cotizar
    Cotizaciones componentes para los proyectos de Baliza y HSB
    [Listado de componentes Baliza y HSB.xlsx, Listado de componentes para proveedor.xlsx]
2020-06-24 Update PCB
    Se actualiza las PCB de acuerdo a los requerimientos del proveedor para la fabricación.
    [HSB-Version1.GBL, HSB-Version1.GBO, HSB-Version1.GBP, HSB-Version1.GBS, HSB-Version1.GM1, HSB-Version1.GTL, HSB-Version1.GTO, HSB-Version1.GTP]
2020-07-03 plantillas htmal
    info de alertas
2020-08-18 Actualización de librerias
    [Listado de componentes para proveedor.xlsx]
2020-09-04 Actualziación baliza
    Ultima actualización de baliza con los cambios de envío de RSSI
    [Listado de componentes Baliza y HSB.xlsx]
2020-10-01 Actualización de Librerias HSB
    Se actualizaron todas las librerias de los sensores y la de control de batería.
2020-10-07 Actualización librerias de Baliza
    Se realizó la corrección del bloqueo de las balizas al momento de escanear los modulos HM10 y se agrego el reinicio automatico despues de 2 minutos sin configurar el Wifi. Se generaron los 2 archivos .BIN para la actualización por OTA de los modulos ESP32, uno correspondiente al servidor de producción y otro al equipo de pruebas.
2020-10-07 Actualización Librerias HSB
    Se realiza la actualización de las librerías finales para el brazalete HSB con las ultimas actualizaciones y tiempos de programación de ejecución de los sensores. Se genera .hex Final.
2020-11-05 Create Componentes Manilla.xls
    [Componentes Manilla.xls]
